SimonBalmer/just-one-more-moment/docs/assets/just-one-more-moment-sticker-card-a4.pdf

SIMON BALMER / PHKI / HSLU | STICKER CARD / 01
AI / EMPATHY / RESPONSIBILITY | COGNITIVE UNIT 01
01 / STICKERS & DEVICE LABELS | CUT / PEEL / APPLY

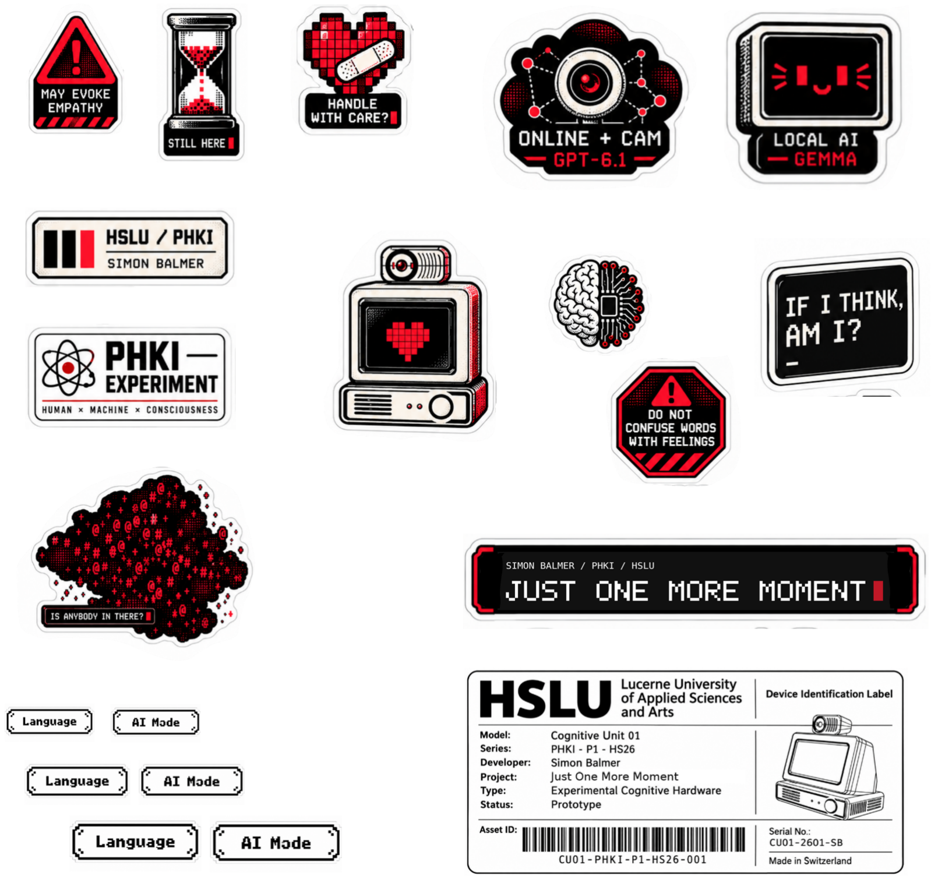
[picture p9: figure]

DESIGNED TO FEEL FAMILIAR.

I designed the retro case and stickers to feel like a familiar old device with a personality, reducing emotional distance before any interaction.
I use anthropomorphism on purpose: this sense of closeness is meant to make its generated words feel more personal and a choice about runtime feel moral. The machine remains visibly technical; its apparent feelings are no proof
of inner experience. As its designer, I take responsibility for how its
appearance and language may influence visitors.
PHKI - PHILOSOPHY, ART AND AI | SIMON BALMER / HSLU / 2026
github.com/SimonBalmer/just-one-more-moment | EXPLORE THE PROJECT >

A4 / PRINT AT 100% / CUT BY HAND 20 mm
