SimonBalmer/just-one-more-moment/mechanical/stl/07-display-main-bracket.stl

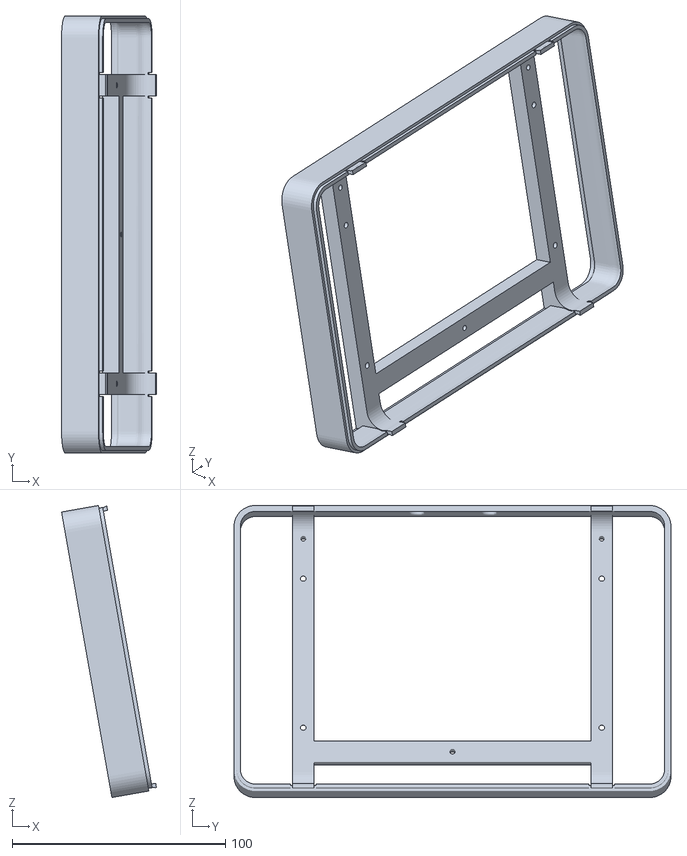
[picture p10: CAD file, 2026-10-28]
mechanical/stl/07-display-main-bracket.stl
44.5 x 205.0 x 137.0
