SimonBalmer/just-one-more-moment/mechanical/stl/03-base-front-trim-left.stl

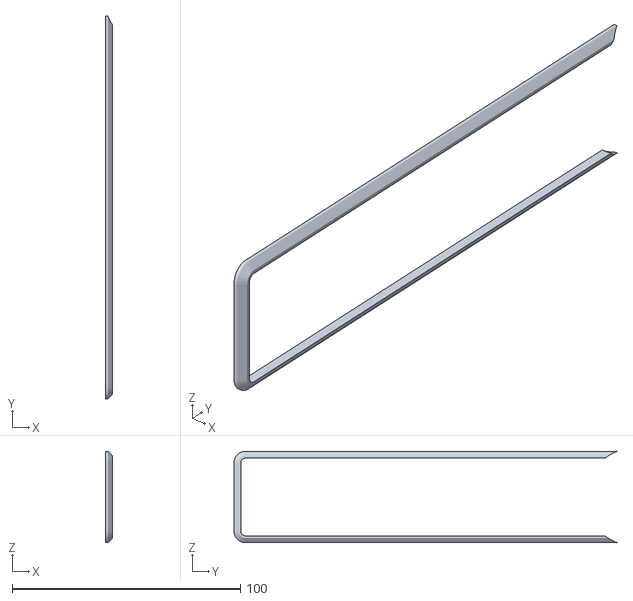
[picture p11: CAD file, 2026-10-28]
mechanical/stl/03-base-front-trim-left.stl
3.00 x 167.8 x 40.0
