SimonBalmer/just-one-more-moment/mechanical/stl/06-rear-cable-guide-lower.stl

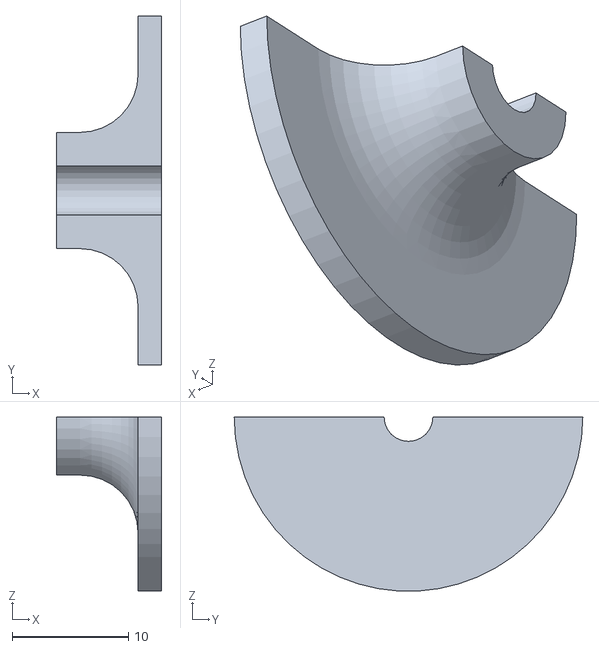
[picture p12: CAD file, 2026-10-28]
mechanical/stl/06-rear-cable-guide-lower.stl
9.00 x 30.0 x 15.0
