SimonBalmer/just-one-more-moment/mechanical/stl/04-base-front-trim-right.stl

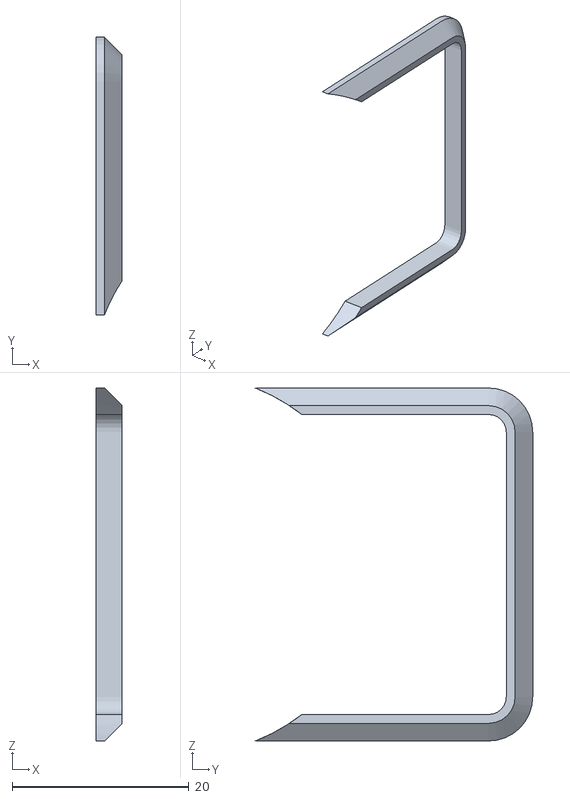
[picture p13: CAD file, 2026-10-28]
mechanical/stl/04-base-front-trim-right.stl
3.00 x 31.4 x 40.0
