SimonBalmer/just-one-more-moment/mechanical/stl/09-display-outer-frame.stl

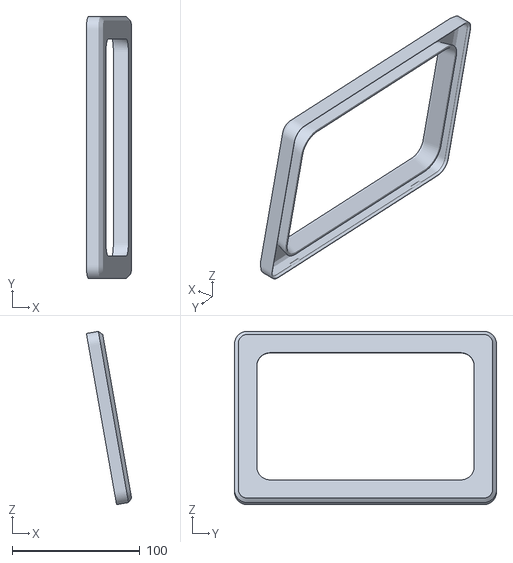
[picture p14: CAD file, 2026-10-28]
mechanical/stl/09-display-outer-frame.stl
35.4 x 205.0 x 135.6
