SimonBalmer/just-one-more-moment/mechanical/stl/12-camera-upper-shell.stl

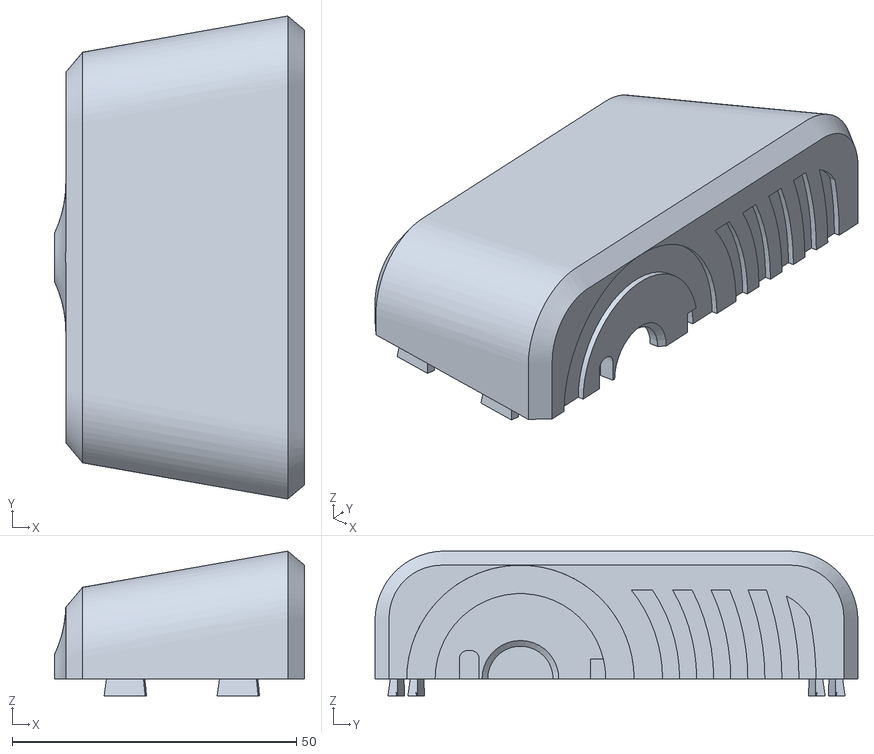
[picture p15: CAD file, 2026-10-28]
mechanical/stl/12-camera-upper-shell.stl
44.0 x 85.0 x 25.5
