SimonBalmer/just-one-more-moment/mechanical/stl/02-base-bottom-cover.stl

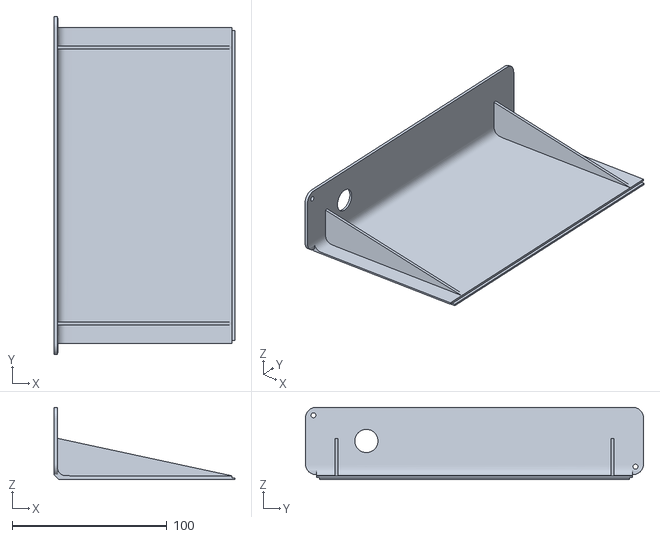
[picture p16: CAD file, 2026-10-28]
mechanical/stl/02-base-bottom-cover.stl
116.8 x 218.5 x 46.8
