SimonBalmer/just-one-more-moment/mechanical/stl/11-camera-lower-shell.stl

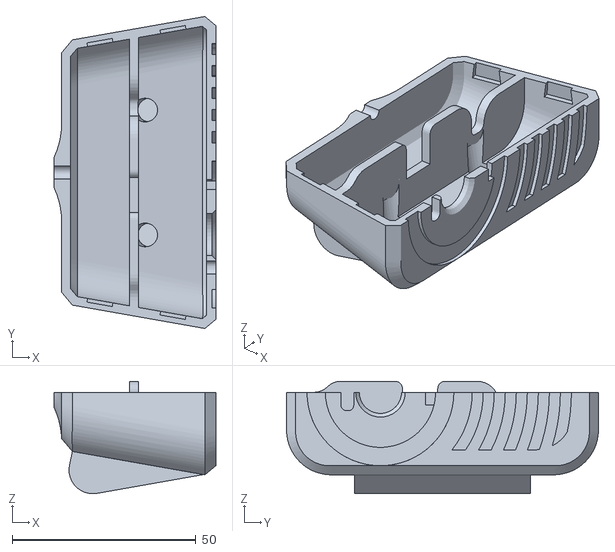
[picture p17: CAD file, 2026-10-28]
mechanical/stl/11-camera-lower-shell.stl
44.0 x 85.0 x 30.6
