SimonBalmer/just-one-more-moment/mechanical/stl/13-camera-lens-ring.stl

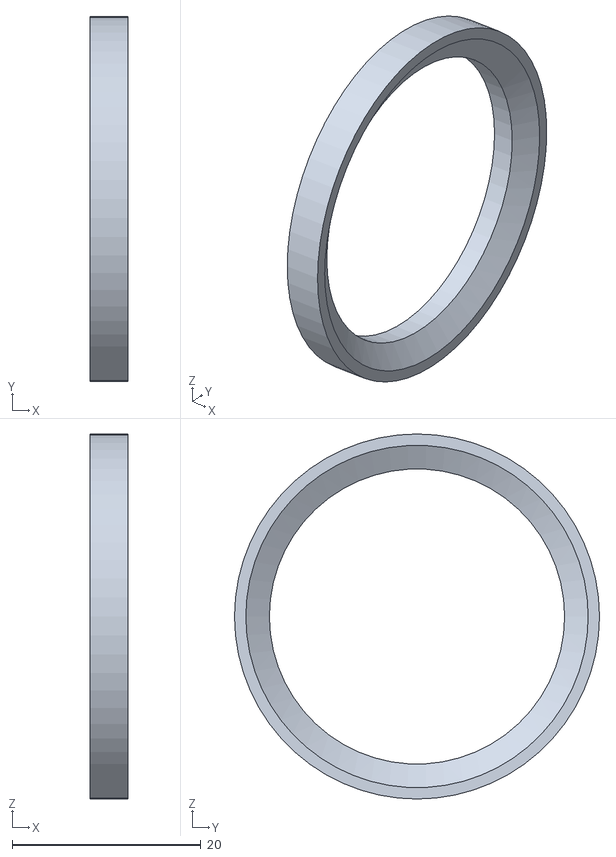
[picture p18: CAD file, 2026-10-28]
mechanical/stl/13-camera-lens-ring.stl
4.00 x 38.7 x 38.7
