SimonBalmer/just-one-more-moment/mechanical/stl/08-display-inner-bezel.stl

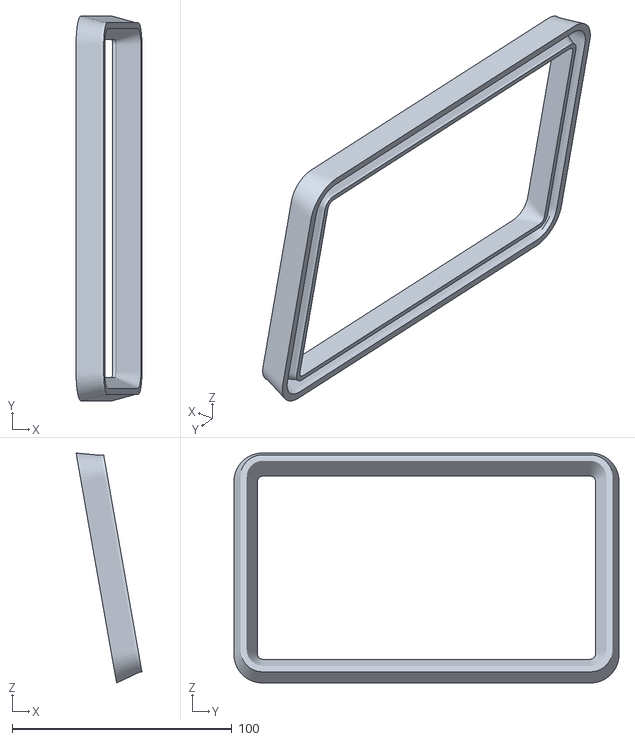
[picture p19: CAD file, 2026-10-28]
mechanical/stl/08-display-inner-bezel.stl
30.0 x 175.4 x 104.8
