SimonBalmer/just-one-more-moment/mechanical/stl/10-display-rear-cover.stl

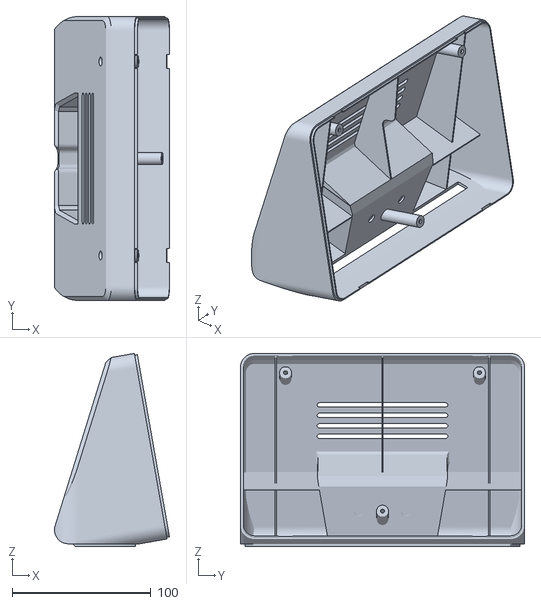
[picture p20: CAD file, 2026-10-28]
mechanical/stl/10-display-rear-cover.stl
83.0 x 205.0 x 139.4
