SimonBalmer/just-one-more-moment/mechanical/stl/01-base-housing.stl

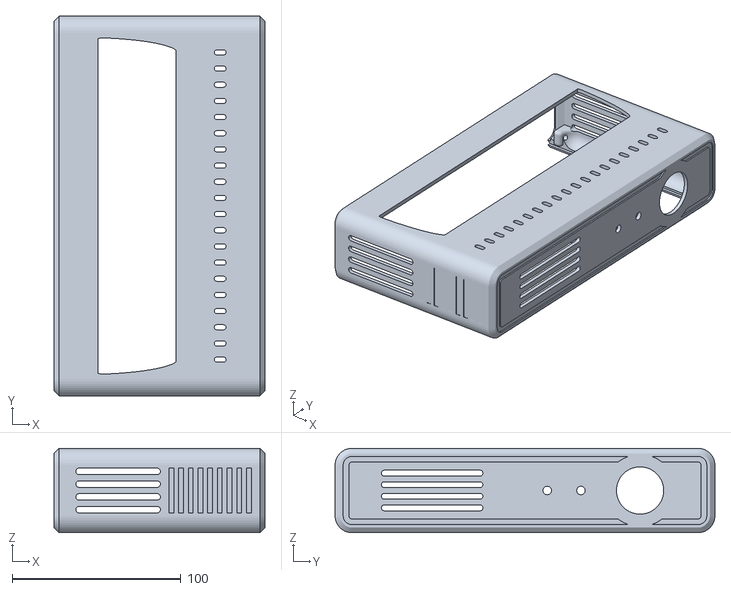
[picture p21: CAD file, 2026-10-28]
mechanical/stl/01-base-housing.stl
125.0 x 225.0 x 50.0
