SimonBalmer/just-one-more-moment/(list of files, cad)

Other CAD files:
mechanical/stl/05-rear-cable-guide-upper.stl
