SimonBalmer/just-one-more-moment/mechanical/assembly/assembly-guide.pdf

## ENCLOSURE / ASSEMBLY

## 01 / EXPLODED ENCLOSURE

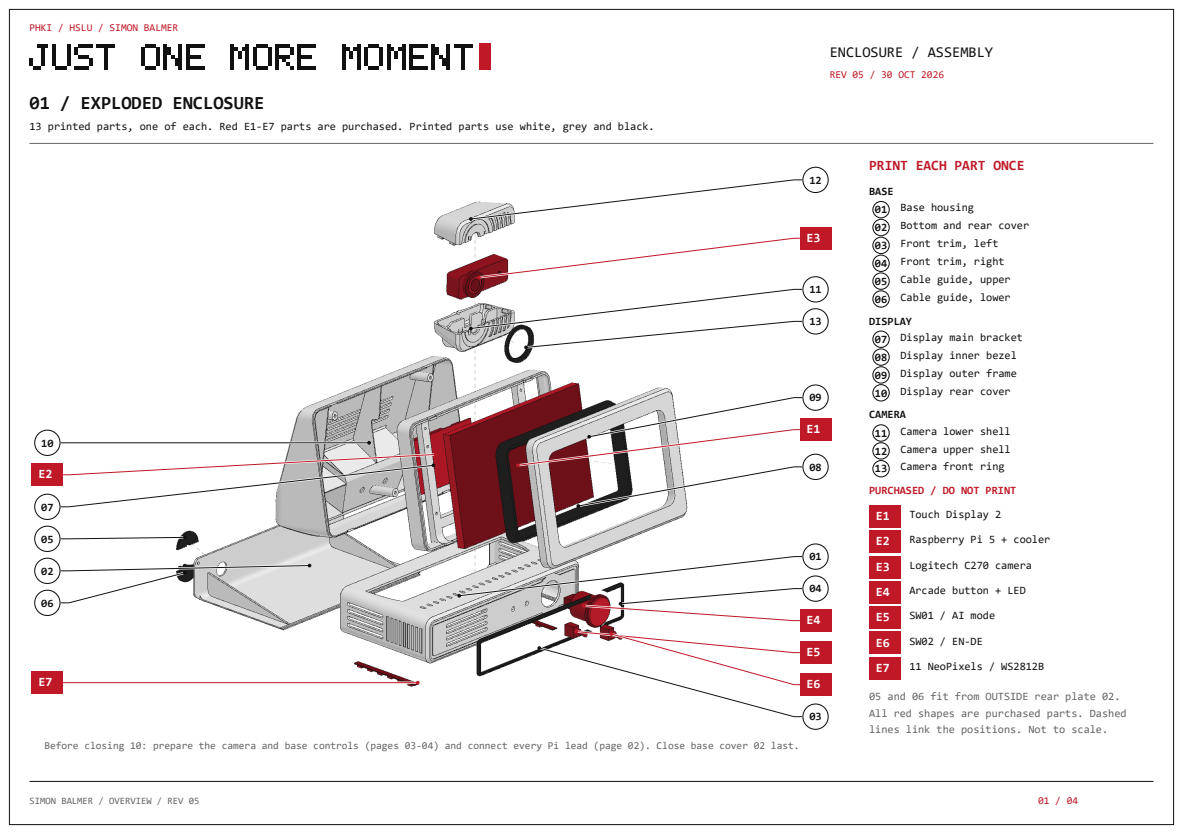
[picture p24: page 1]
REV 05 / 30 OCT 2026; SIMON BALMER / OVERVIEW / REV 05; Touch Display 2; Raspberry Pi 5 + cooler; Logitech C270 camera; Arcade button + LED; SW01 / AI mode; 11 NeoPixels / WS2812B

PHKI / HSLU / SIMON BALMER

13 printed parts, one of each. Red E1-E7 parts are purchased. Printed parts use white, grey and black.

PRINT EACH PART ONCE

BASE
01 Base housing
02 Bottom and rear cover
03 Front trim, left
04 Front trim, right
05 Cable guide, upper
06 Cable guide, lower

DISPLAY
07 Display main bracket
08 Display inner bezel
09 Display outer frame
10 Display rear cover

CAMERA
11 Camera lower shell
12 Camera upper shell
13 Camera front ring

PURCHASED / DO NOT PRINT

05 and 06 fit from OUTSIDE rear plate 02.
All red shapes are purchased parts. Dashed
lines link the positions. Not to scale.

Before closing 10: prepare the camera and base controls (pages 03-04) and connect every Pi lead (page 02). Close base cover 02 last.

REV 05 / 30 OCT 2026

## 02 / DISPLAY AND RASPBERRY PI

Build the front screen unit first. Glue 10 to 01 before wiring. Finish every Pi connection before closing 10.

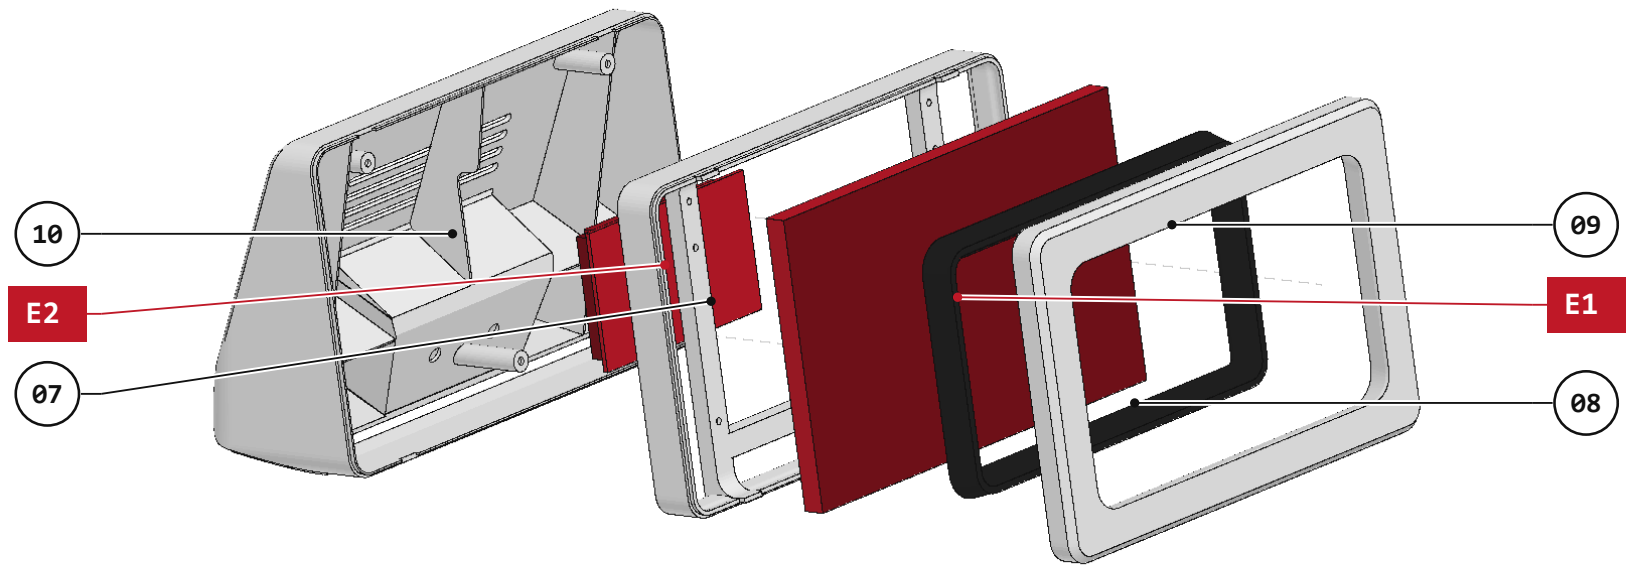
[picture p25: figure]
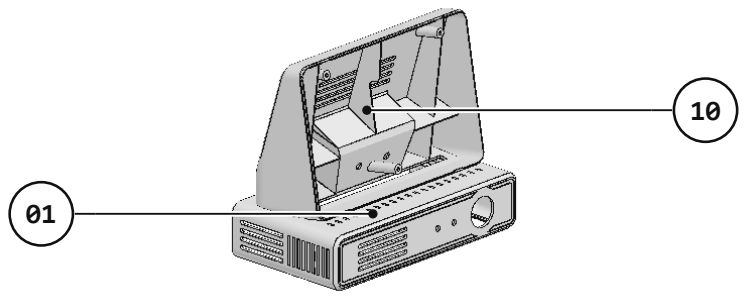
[picture p26: figure]

SIMON BALMER / DISPLAY / REV 05 | 02 / 04

GLUE 10 TO 01 / BEFORE WIRING DISPLAY FIXINGS

Supplied display screws: Pi to E1, then the four outer points on 07.

Final closure: 3 x 2.9 x 9.5 mm sheet-metal / wood screws, or similar.

1 / MOUNT THE PI ON THE DISPLAY

Screw Pi E2 to display E1 using the supplied display screws and its threaded mounting points. Connect the display power and data cables to the Pi now. Follow the official Touch Display 2 instructions.

2 / BUILD THE FRONT SCREEN UNIT

Use the display screws to attach the display/Pi unit to bracket 07 at the four outer threaded mounting points. Slide 08 and 09 into each other, then click this pair onto 07. The front screen unit is complete.

3 / GLUE THE REAR COVER TO THE BASE

Before wiring the device, glue rear cover 10 to base housing 01. I use UHU Kraftkleber (strong adhesive). Let the bond set as directed on the adhesive packaging.

4 / CONNECT AND ROUTE THE CABLES

Prepare the camera and base controls as shown on pages 03-04. Connect all leads to the Pi using build/README.md, step 5. Route the jumper leads, camera USB cable and Pi power cable through the lower opening in 10 into the base.

5 / CLOSE THE DISPLAY HOUSING

Fit the front screen unit onto 10. Use its three screw guides and three 2.9 x 9.5 mm sheet-metal or wood screws, or similar screws that fit. Complete all Pi connections before this step; no further access is needed.

Official Touch Display 2 setup guide (https://www.raspberrypi.com/documentation/accessories/touch-display-2.html)

REV 05 / 30 OCT 2026

## 03 / BASE, FRONT CONTROLS AND CABLES

Complete steps 1-3 while the Pi is accessible. After closing 10 (page 02), finish the cable routing and close 02.

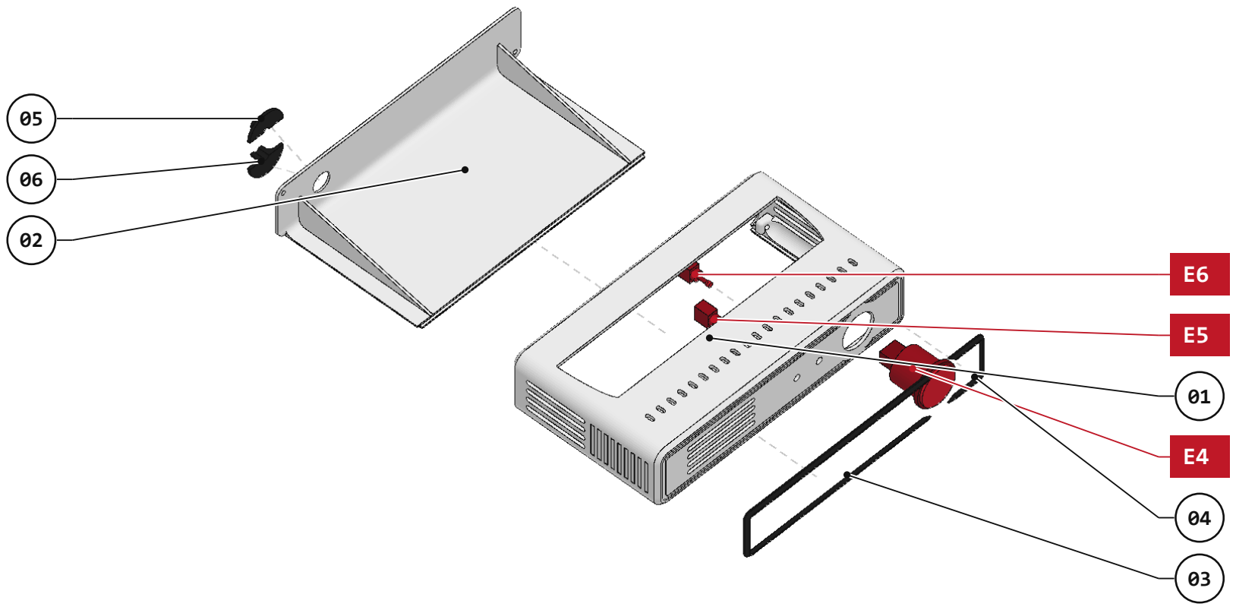
[picture p27: figure]
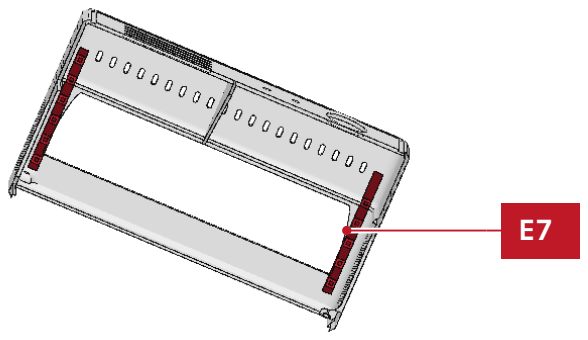
[picture p28: figure]
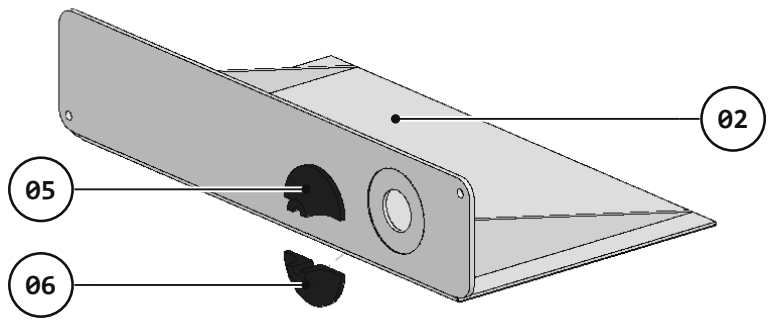
[picture p29: figure]

SIMON BALMER / BASE / REV 05 | 03 / 04
E7 / UNDER THE BASE CEILING | 05 + 06 / OUTSIDE PLATE 02
Cutaway: cover 02 and lower lip hidden. | Upper: 05 / Lower: 06. Clamp the power lead.

1 / PREPARE THE CONTROL LEADS

Prepare and solder the jumper leads in advance using build/README.md, step 5. Insulate the solder joints as shown in the wiring guide.

2 / GLUE TRIMS AND FIT THE CONTROLS

Glue trims 03 and 04 into their guides. Insert the large arcade button E4 from the front. Insert switches E5 and E6 from inside the housing, then secure them with their mounting nuts.

3 / PLACE AND WIRE THE LEDS

Use the self-adhesive backing to place the 11 NeoPixels E7 under the inside ceiling of 01. Spread them so their light shines through the side vents. Wire E4-E7 to the Pi using the wiring guide before closing the display housing.

4 / STORE AND ROUTE THE CABLES

With the wiring complete, loosely coil the spare camera USB cable inside the base. Lead the Pi power cable out through rear plate 02. Fit cable-guide halves 05 and 06 from the outside of 02 around the cable and secure it.

5 / CLOSE THE BASE

Fit bottom/rear cover 02 to housing 01 and fasten it with two suitable screws or bolts and two matching nuts. Choose pairs that fit the printed fixing holes.

Final base closure: 2 screws/bolts + 2 nuts.

REV 05 / 30 OCT 2026

## 04 / LOGITECH C270 AND CAMERA SHELLS

The shallow camera reaches only to the middle divider in 11. Part 12 is the upper shell; ring 13 finishes the front.

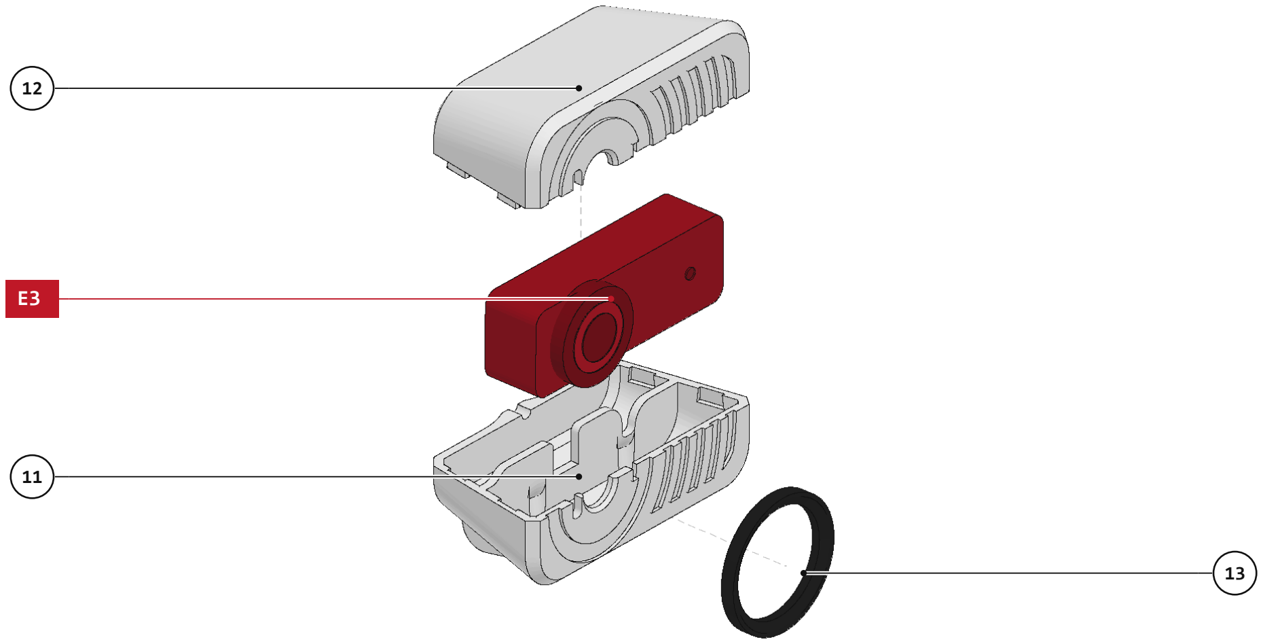
[picture p30: figure]

SIMON BALMER / CAMERA / REV 05 | 04 / 04

1 / FIT AND SECURE THE CAMERA

Place camera E3 in lower shell 11, with the lens at the front opening. The shallow body reaches only to the middle divider in 11. Secure it with glue or tape, and lead its USB cable out through the rear.

2 / CLICK THE TWO SHELLS TOGETHER

Push 11 and 12 together. Slight pressure from the left and right sides of upper shell 12 makes it easier to fit.

3 / GLUE THE FRONT RING

Glue front ring 13 into place to join and finish the camera housing.

PARTS IN THIS VIEW

### 11 Lower camera shell

### 12 Upper camera shell

### 13 Front ring

E3 Logitech C270

SHALLOW CAMERA / REAR CABLE EXIT

Secure E3 in the front half of 11. Run its USB cable out at the back, then into the device. Coil the spare length in the base (page 03).
