SimonBalmer/just-one-more-moment/mechanical/assembly/base-assembly.png

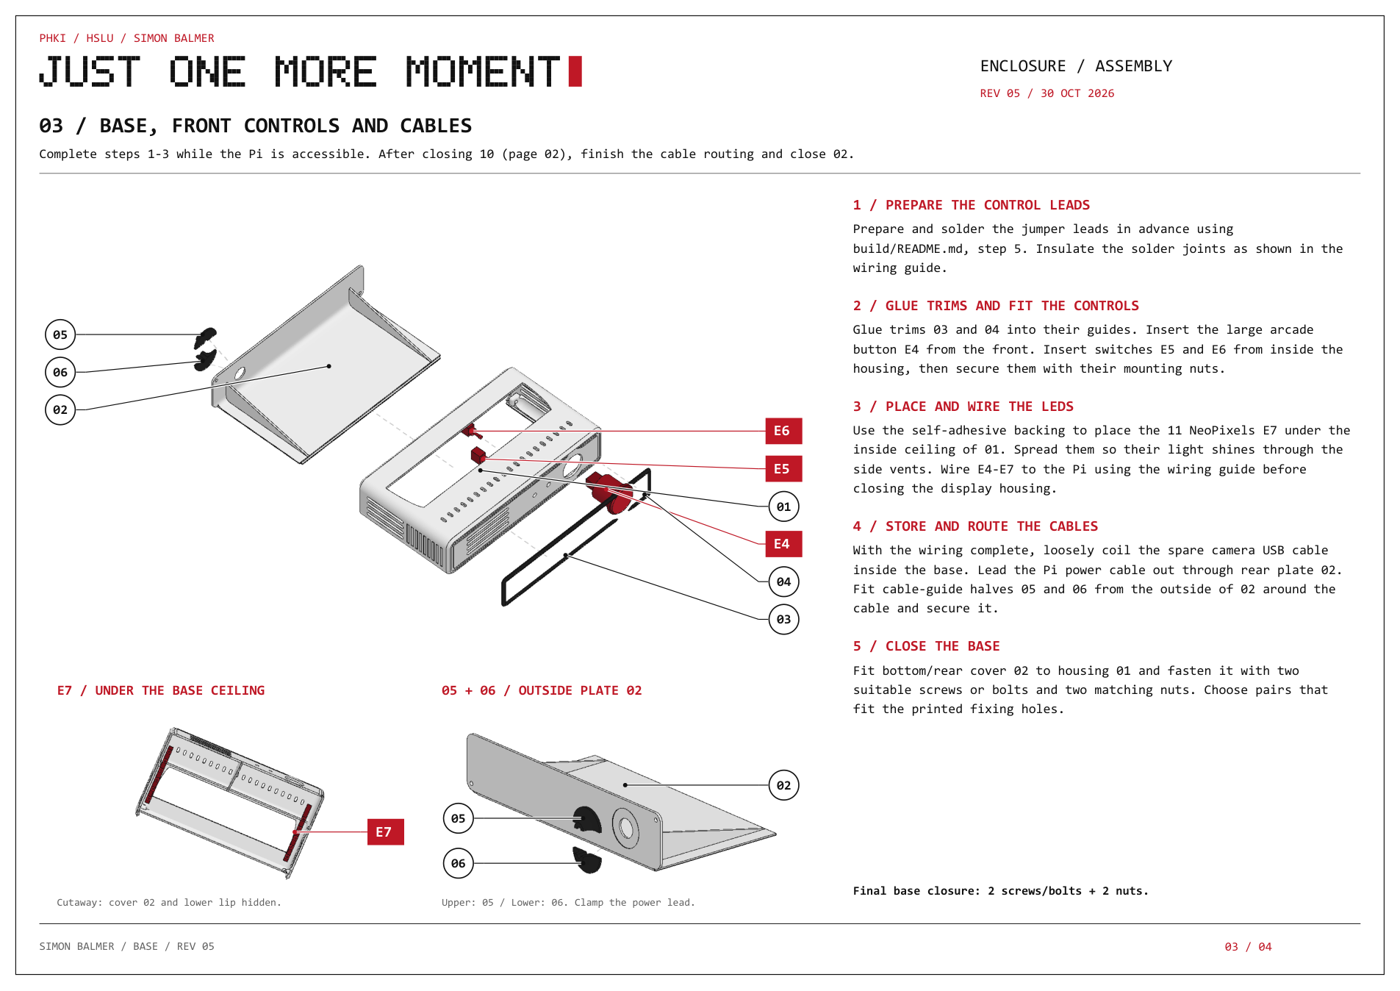
mechanical/assembly/base-assembly.png
