SimonBalmer/just-one-more-moment/mechanical/assembly/camera-assembly.png

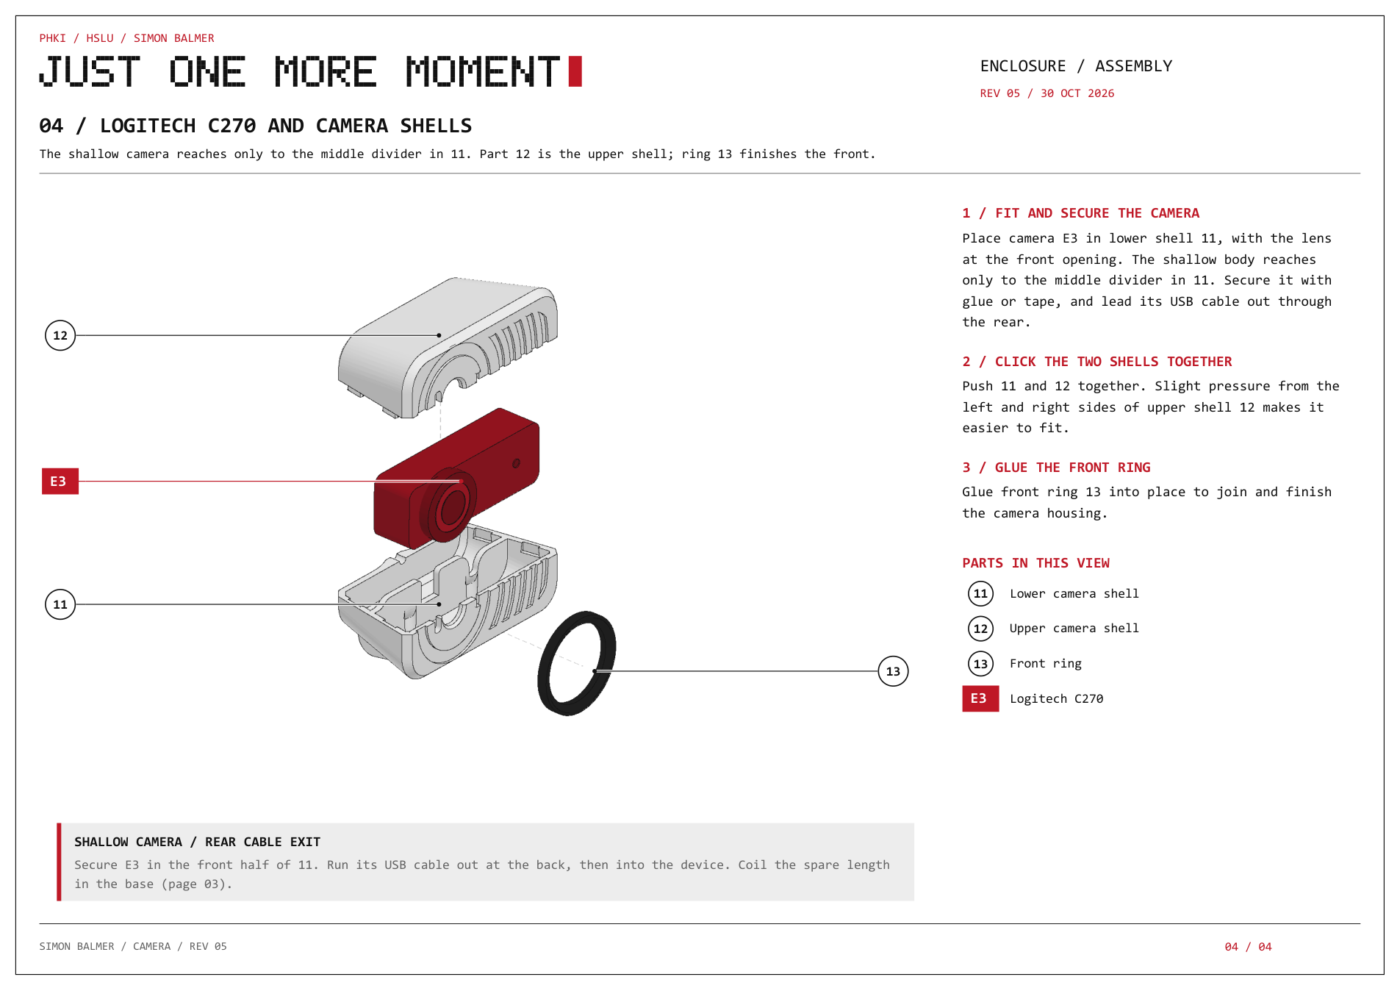
mechanical/assembly/camera-assembly.png
