SimonBalmer/just-one-more-moment/mechanical/assembly/display-assembly.png

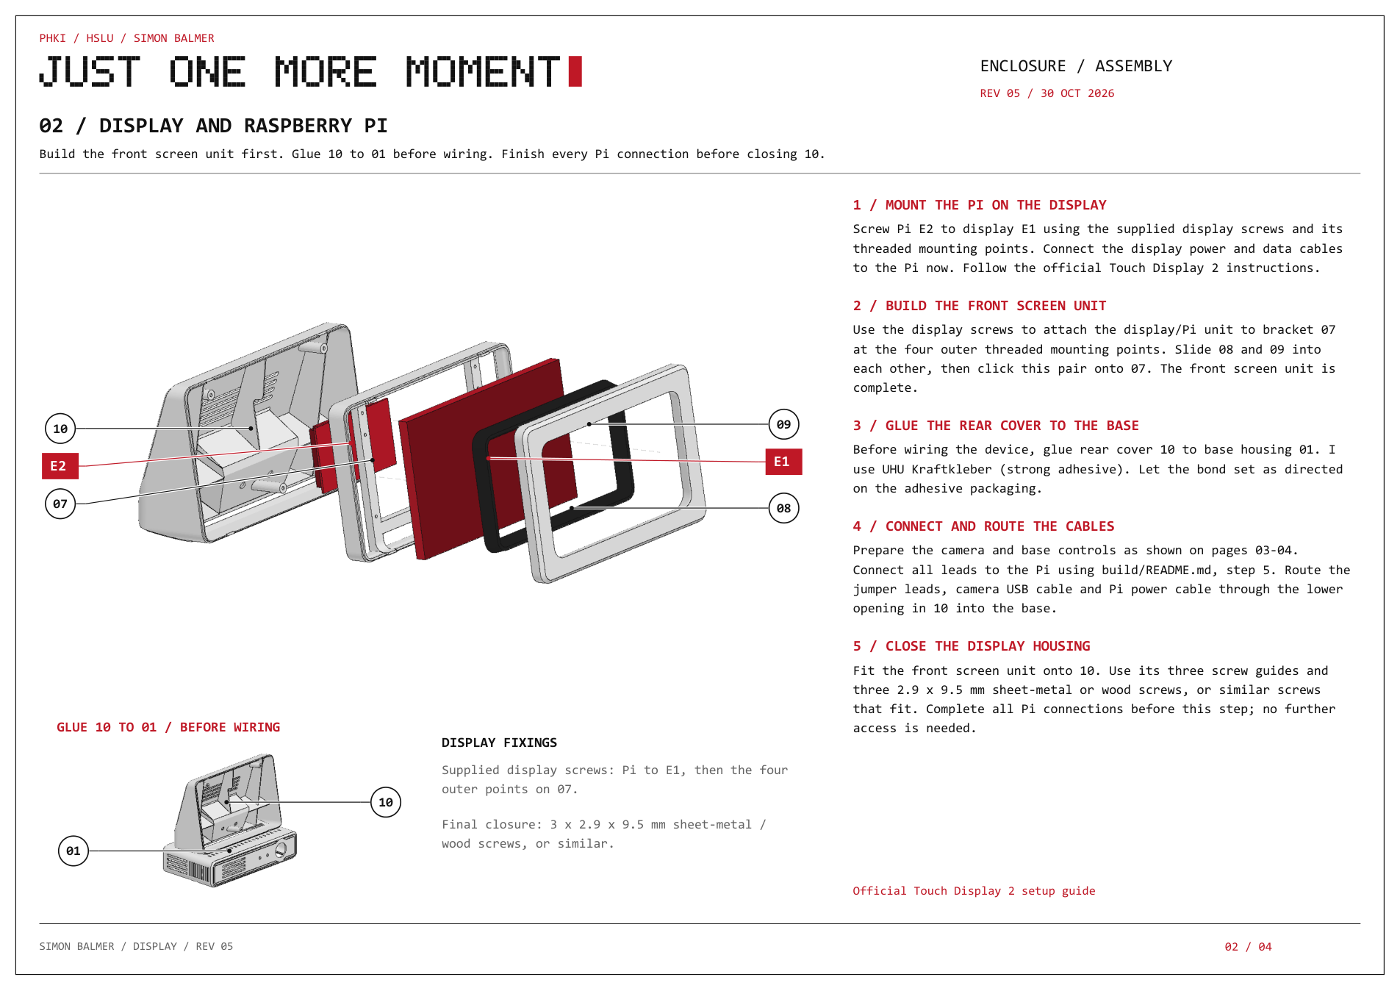
mechanical/assembly/display-assembly.png
