SimonBalmer/just-one-more-moment/hardware/diagrams/wiring-overview.pdf

## WIRING OVERVIEW

## RASPBERRY PI 5

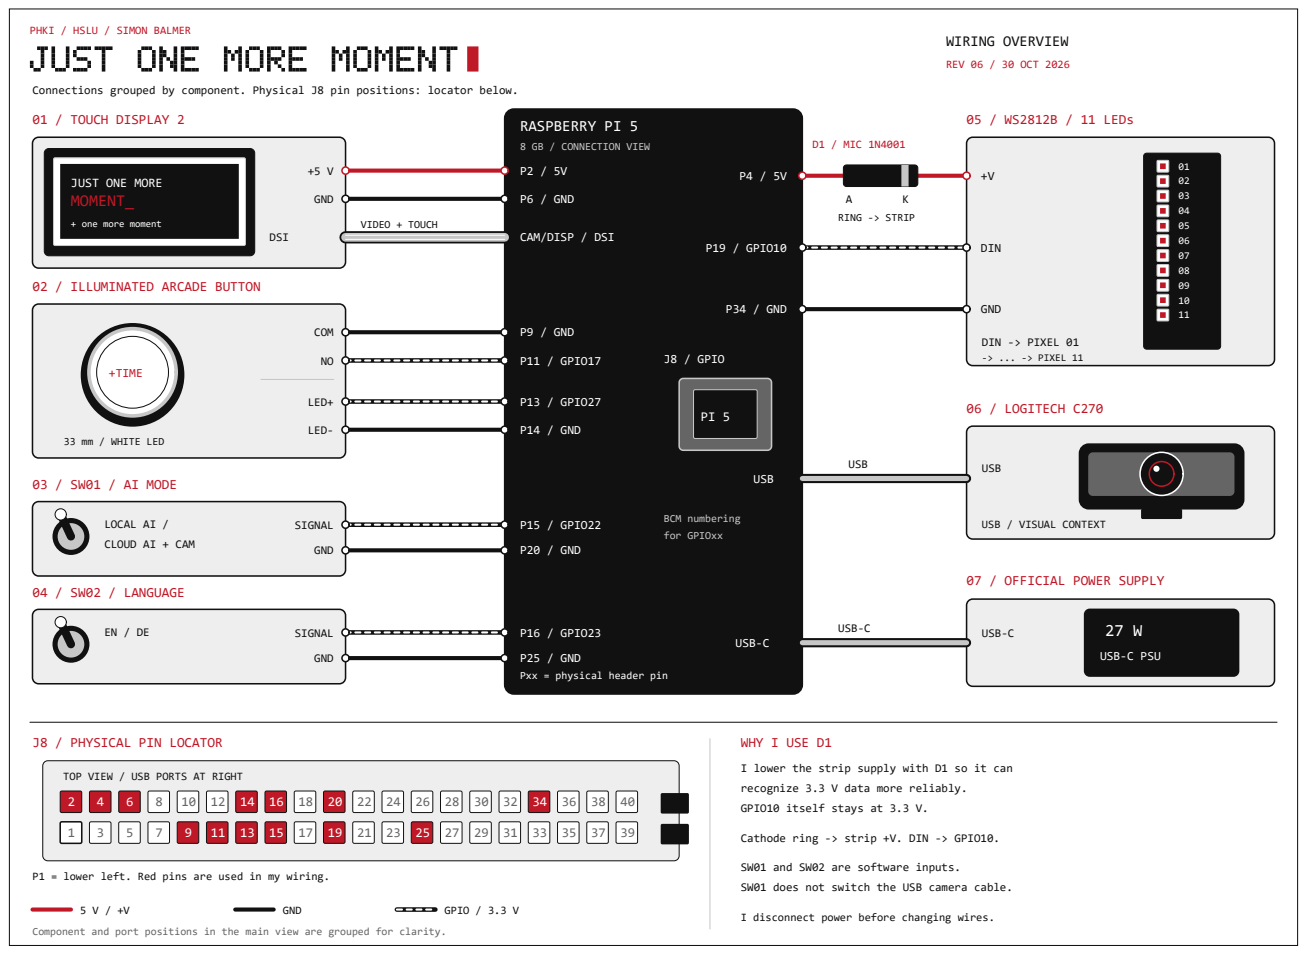
[picture p35: page 1]

PHKI / HSLU / SIMON BALMER

Connections grouped by component. Physical J8 pin positions: locator below.

Pxx = physical header pin

I lower the strip supply with D1 so it can
recognize 3.3 V data more reliably.
GPIO10 itself stays at 3.3 V.

TOP VIEW / USB PORTS AT RIGHT

Cathode ring -> strip +V. DIN -> GPIO10.

SW01 and SW02 are software inputs.
SW01 does not switch the USB camera cable.

P1 = lower left. Red pins are used in my wiring.

Component and port positions in the main view are grouped for clarity.
