SimonBalmer/just-one-more-moment/(commit log)

2026-10-28 Add labelled retro wiring diagram and write documentation in first person
2026-10-28 Finalize wiring with MIC 1N4001, P4/P34 supply and labelled mode selectors
2026-10-28 Improve wiring readability with grouped terminals and physical pin locator
2026-10-28 Document jumper-wire assembly and add build photos
2026-10-28 Add 13 numbered enclosure STLs, print pack and illustrated assembly guide
    [01-base-housing.stl, 02-base-bottom-cover.stl, 03-base-front-trim-left.stl, 04-base-front-trim-right.stl, 05-rear-cable-guide-upper.stl, 06-rear-cable-guide-lower.stl, 07-display-main-bracket.stl, 08-display-inner-bezel.stl]
2026-10-28 Match enclosure guide to retro wiring style and show all purchased components
2026-10-28 Finalize four-page enclosure guide with confirmed assembly steps and part placement
2026-10-30 docs: link printable A4 sticker sheet from docs/design.md
2026-10-30 docs: link printable A4 sticker sheet from docs/README.md
2026-10-30 docs: link printable A4 sticker sheet from README.md
2026-10-30 Add complete Raspberry Pi application source
2026-10-30 Add missing software assets, documentation and tests
    [test_browser.py, test_camera_preview.py, test_cloud_model.py, test_launcher.py, test_life_hardware.py, test_lifecycle.py, test_model.py, test_network_setup.py]
2026-10-30 Add finished prototype photos and update media README
2026-10-30 Remove obsolete development assets and compact agent guidance
    [10-display-rear-cover-original.stl]
2026-10-30 Clarify that visitor observations refer to cloud camera mode
2026-10-30 Prepare six compact video stages for the product walkthrough
2026-10-30 Insert video links for life simulation stages
    Added video URLs for each stage of the life simulation.
